22060/2026_koreisai_HW/circuit/output/別紙.pdf

## 1 フットプリント指定について

## 1.1 Mounting Hole

表 1, 画像 1 に示す．

表 1: Mounting Hole のフットプリント指定
項目 | 値 | 単位 | 備考
Pad Diameter | – | –
Hole Diameter | 3.2 | mm
Keepout Diameter | 6.4 | mm

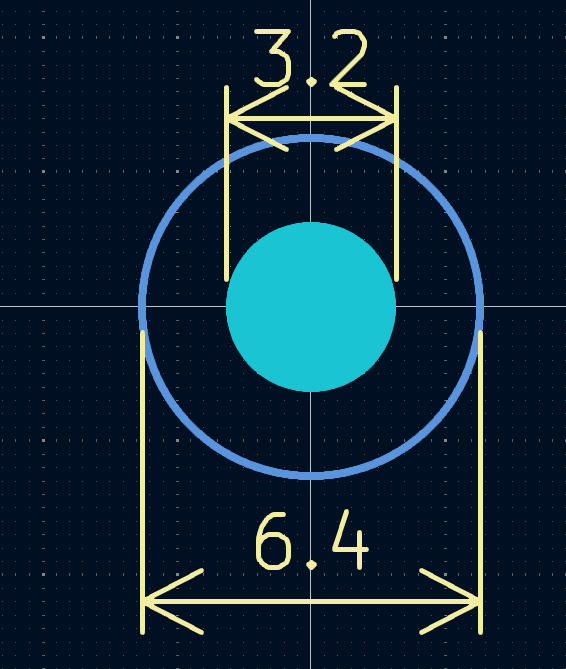
[picture p1: figure]

図 1: Mounting Hole のフットプリント

1.1.1 J2 のフットプリント指定
表 2, 画像 2 に示す．このフットプリントは USB コネクタの配置をせずとも，USB 機能を使用 できるようにするためのものであり，プローブ基板を用いてプログラムの書き込みをできるように するためのものである．

表 2: J2 のフットプリント指定
項目 | 値 | 単位 | 備考
Pad Diameter | 1.7 | mm
Hole Diameter | 1.0 | mm
Keepout Diameter | 0 | mm
pad to pad | 2.54 | mm
amount of pad | 4 | –

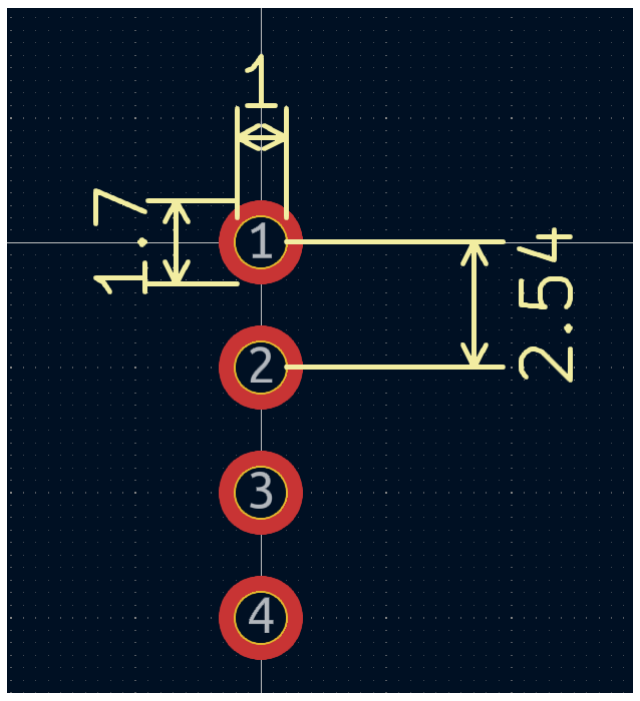
[picture p2: figure]

図 2: J2 のフットプリント

1.1.2 J3 のフットプリント指定
表 3, 画像 3 に示す．このフットプリントはモジュール型の IMU を搭載するときに使用するもの である．ピンヘッダを用いて，基板外に配置するモジュールとの配線を行う方式にする．

表 3: J3 のフットプリント指定
項目 | 値 | 単位 | 備考
Pad Diameter | 1.7 | mm
Hole Diameter | 1.0 | mm
Keepout Diameter | 1.77 | mm
pad to pad | 2.54 | mm
amount of pad | 10 | –

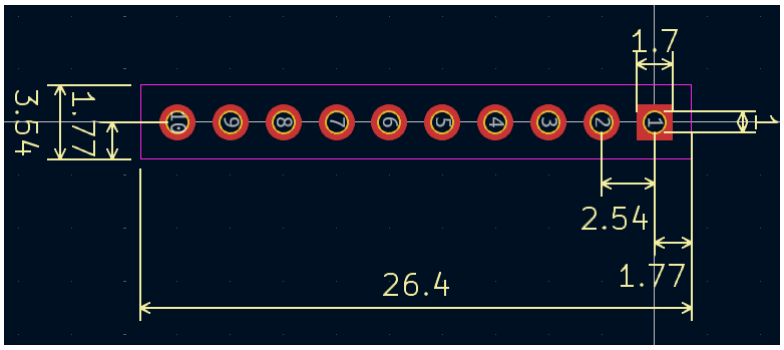
[picture p3: figure]

図 3: J3 のフットプリント

### 1.2 JP1 のフットプリント指定

表 4, 画像 4 に示す．このフットプリントにより，SMD タイプの IMU の I2C アドレスの指定を 行う．

表 4: JP1 のフットプリント指定
項目 | 値 | 単位 | 備考
Pad width | 1.0 | mm
Pad length | 1.5 | mm
Pad to pad | 1.3 | mm

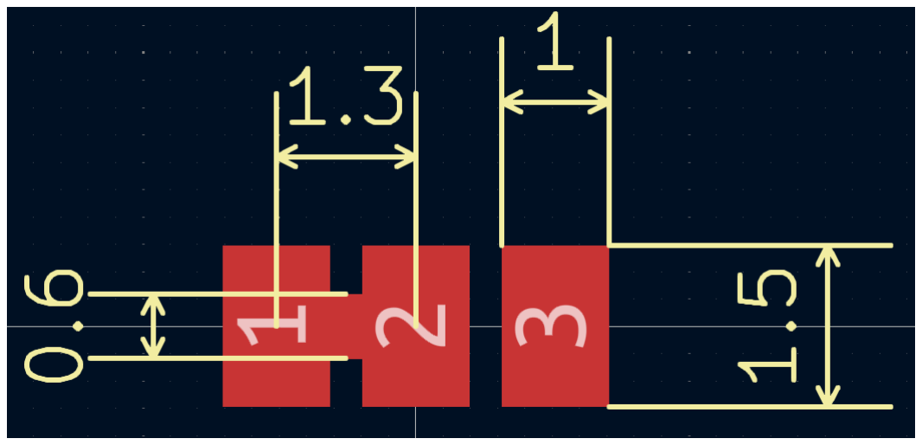
[picture p4: figure]

図 4: JP1 のフットプリント

## 1.3 ESP32-C3-WROOM-02 のフットプリント指定

ESP32-C3-WROOM-02(MCU) のフットプリントについては，データシートが二種類あるた め，こちらに記載を行う．フットプリント等本体仕様については， https://documentation.espressif.com/esp32-c3_datasheet_en.pdf#cd-func-descr に記載されている．ハードウェア設計においては，
https://docs.espressif.com/projects/esp-hardware-design-guidelines/en/latest/esp32c3/pcb-layout-design.html (https://docs.espressif.com/projects/esp-hardware-design-guidelines/en/latest/esp32c3/pcb-layout-design.html)
に記載されている．アンテナ周りのキープアウト等の事項は，ハードウェア設計のほうに記載され ているため，そちらを参照してほしいです．

## 2 シルクスクリーンの表記について

シルクスクリーンの表記については，抵抗/キャパシタ/ダイオードについては RXX/CXX/DXX （XX は部品番号）のように表記する．
また，コネクタである JXX についても同様に JXX（XX は部品番号）のように表記する．（J2 に ついては後述）
IC1,Q1,UX についても同様に IC1/Q1/UX（X は部品番号）のように表記する．
buttonX については button1 のみ RST，その他は buttonX（X は部品番号）のように表記する． JP1 においては，回路図に書かれてる値をシルクスクリーンの表記にする．
J2 においては信号線名を各ピンのそばに表記する．

## 3 大電流箇所について

回路図の MORTOR における箇所においては，ピーク電流が 3.0 A，定常値で 1.0 A 流れること が想定される．そのほかの回路においては最大で 0.3 A 程度の電流（3.3V のレギュレータの出力 直後）が流れることが想定される．

## 4 サーマルパッドについて

5V から 3.3V への降圧に使用する IC まわりにおいては，0.6W 程度の発熱が想定されるため， 放熱用のサーマルパッド/ビアの設置をお願いしたいです．

## 5 外形について

基板の外径については，幅を 30 mm，高さを 150 mm までとし，小さい事には問題がないです． また，Mounting Hole については，基板の四隅に配置をお願いしたいですが，最低でも対角の 2 か 所についていれば問題ないです．コンポーネントの配置や，Mounting Hole の細かな配置において は指定をしないですが，ESP32-C3-WROOM-02 のアンテナについてもこの外形内の収まるよう にしてもらいたいです．
以上について，よろしくお願いします．
設計担当者：古城 隆人
