22060/2026_koreisai_HW/circuit/image/J2.png

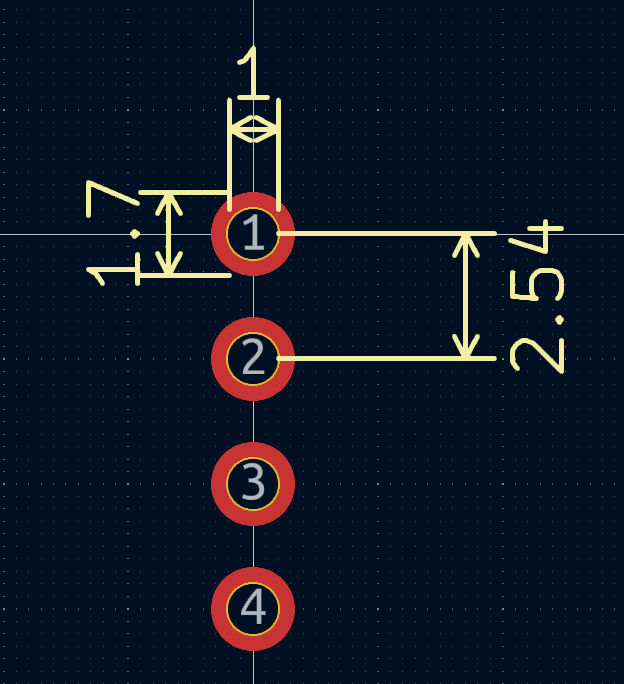
circuit/image/J2.png
