22060/2026_koreisai_HW/circuit/image/J3.png

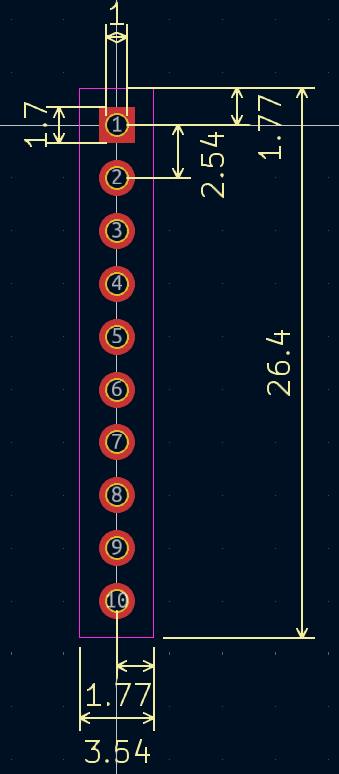
circuit/image/J3.png
