22060/2026_koreisai_HW/circuit/image/JP1.png

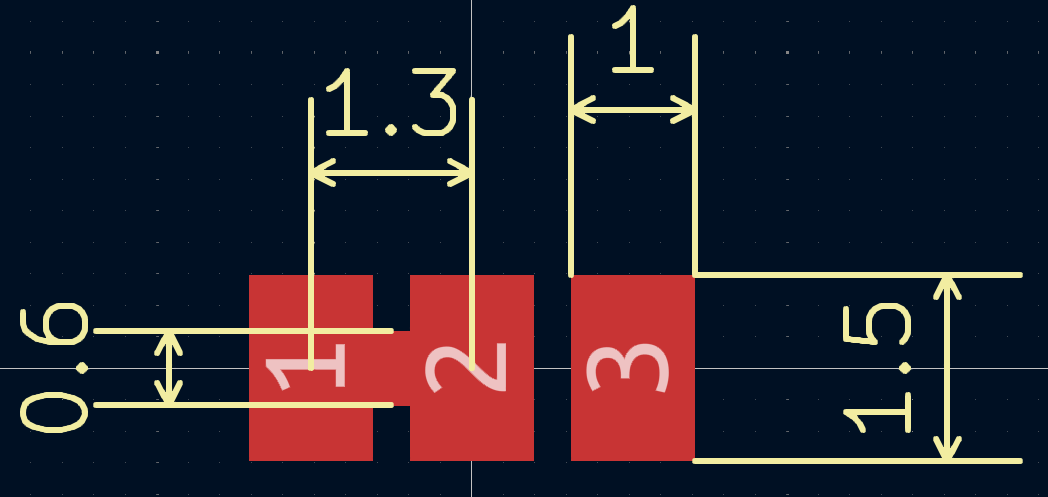
circuit/image/JP1.png
