22060/2026_koreisai_HW/circuit/jlcpcb/production_files/BOM-circuit.csv

Comment | Designator | Footprint | LCSC | Quantity
0.1u | C23 | C_0603_1608Metric | C52923 | 1
10k | R6 | R_0603_1608Metric_Pad0.98x0.95mm_HandSolder | C25744 | 1
5.1k | R23,R24 | R_0603_1608Metric | C23186 | 2
10k | R1 | R_0603_1608Metric_Pad0.98x0.95mm_HandSolder |  | 1
1u | C1 | C_0603_1608Metric |  | 1
1u | C8 | C_0603_1608Metric |  | 1
0.1u | C7 | C_0603_1608Metric |  | 1
0.1u | C6 | C_0603_1608Metric |  | 1
10k | R2 | R_0603_1608Metric_Pad0.98x0.95mm_HandSolder |  | 1
BNO085 | IC1 | BNO085 |  | 1
0.1u | C9 | C_0603_1608Metric |  | 1
TestPoint | TP2 | TestPoint_Pad_D1.5mm |  | 1
10u | C4 | C_0603_1608Metric |  | 1
10u | C5 | C_0603_1608Metric |  | 1
TestPoint | TP4 | TestPoint_Pad_D1.5mm |  | 1
TestPoint | TP3 | TestPoint_Pad_D1.5mm |  | 1
BD33FC0FP | U2 | TO-252-2 |  | 1
USB_C_Receptacle_USB2.0 | J3 | USB_C_Receptacle_GCT_USB4105-xx-A_16P_TopMnt_Horizontal |  | 1
TestPoint | TP1 | TestPoint_Pad_D1.5mm |  | 1
ESP32-C3-WROOM-02 | U1 | ESP32-C3-WROOM-02 |  | 1
Conn_01x10_Pin | J4 | PinHeader_1x10_P2.54mm_Vertical |  | 1
10u | C2 | C_0603_1608Metric |  | 1
4.7k | R3 | R_0603_1608Metric_Pad0.98x0.95mm_HandSolder |  | 1
4.7k | R4 | R_0603_1608Metric_Pad0.98x0.95mm_HandSolder |  | 1
0.1u | C3 | C_0603_1608Metric |  | 1
SW_Push | RST | SW_SPST_PTS810 |  | 1
SW_Push | boot | SW_SPST_PTS810 |  | 1
