22060/2026_koreisai_HW/circuit/circuit.kicad_pcb

## KiCad design circuit/circuit.kicad_pcb (2026-08-03)

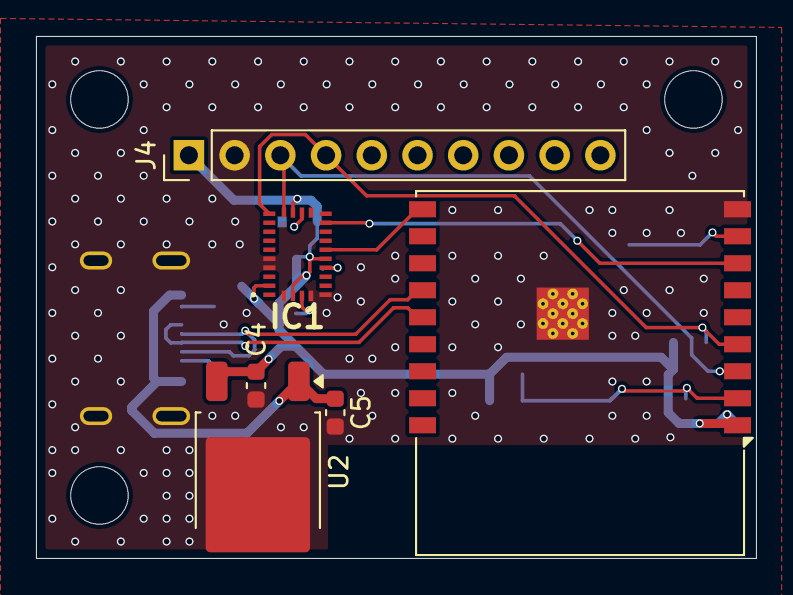
[picture p8: board circuit.kicad_pcb from above]

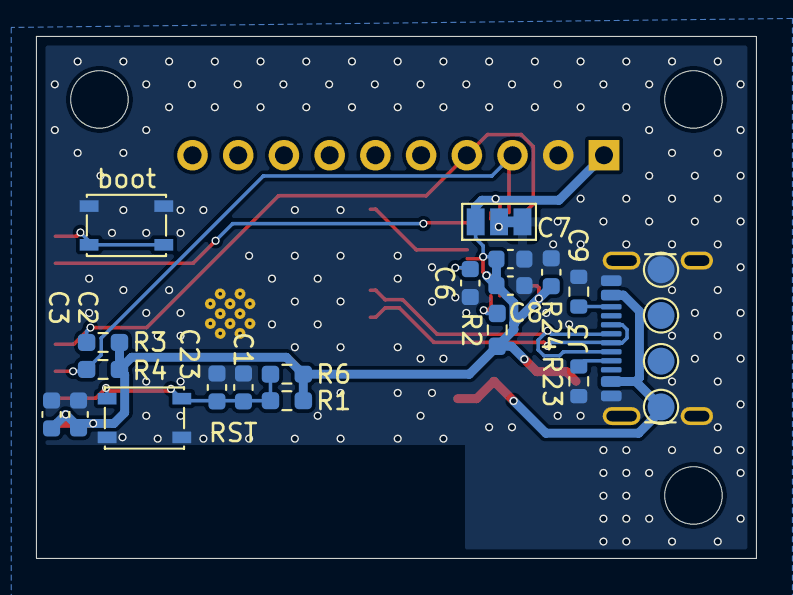
[picture p9: board circuit.kicad_pcb from below]

Board: 2 copper layers, 40.0 x 29.0 mm, 32 parts (23 on the bottom side), 16 nets.

Parts:
C1, C8: 1u; C_0603_1608Metric
C2, C4, C5: 10u; C_0603_1608Metric
C3, C6, C7, C9, C23: 0.1u; C_0603_1608Metric
H1, H2, H3: MountingHole; MountingHole_3.2mm_M3
IC1: BNO085
J3: USB_C_Receptacle_USB2.0; USB_C_Receptacle_GCT_USB4105-xx-A_16P_TopMnt_Horizontal
J4: Conn_01x10_Pin; PinHeader_1x10_P2.54mm_Vertical
JP1: Jumper_3_Bridged12; SolderJumper-3_P1.3mm_Bridged12_Pad1.0x1.5mm_NumberLabels
R1, R2, R6: 10k; R_0603_1608Metric_Pad0.98x0.95mm_HandSolder
R3, R4: 4.7k; R_0603_1608Metric_Pad0.98x0.95mm_HandSolder
R23, R24: 5.1k; R_0603_1608Metric
RST: SW_Push; SW_SPST_PTS810
TP1, TP2, TP3, TP4: TestPoint; TestPoint_Pad_D1.5mm
U1: ESP32-C3-WROOM-02
U2: BD33FC0FP; TO-252-2
boot: SW_Push; SW_SPST_PTS810

Connections:
+3.3V: C2.2, C3.2, C4.1, C7.1, C8.1, C9.1, IC1.3 (VDD), IC1.10 (CLKSEL0), IC1.18 (H_CSN), IC1.28 (VDDIO), J4.1, JP1.3 (B), R1.2, R2.1, R3.1, R4.1, R6.2, U1.1 (3V3), U2.3 (VO)
+5V: C5.1, J3.A4 (VBUS), J3.A9 (VBUS), J3.B4 (VBUS), J3.B9 (VBUS), TP1.1, U2.1 (VCC)
BOOT: U1.8 (IO9), boot.2
D+: J3.A6 (D+), J3.B6 (D+), U1.14 (IO19)
D-: J3.A7 (D-), J3.B7 (D-), U1.13 (IO18)
GND: C1.2, C2.1, C3.1, C4.2, C5.2, C6.1, C7.2, C8.2, C9.2, C23.2, IC1.2 (GND_1), IC1.5 (PS1), IC1.6 (PS0/WAKE), IC1.25 (GND_2), IC1.26 (XOUT32/CLKSEL1), J3.A1 (GND), J3.A12 (GND), J3.B1 (GND), J3.B12 (GND), J3.S1 (SHIELD), J4.2, JP1.1 (A), R23.2, R24.2, RST.1, TP4.1, U1.9 (GND), U1.19 (GND), U2.2 (GND), boot.1
NRST: C1.1, C23.1, R1.1, R6.1, RST.2, U1.2 (EN)
unnamed: IC1.4 (BOOTN), R2.2
unnamed: C6.2, IC1.9 (CAP)
unnamed: IC1.17 (SA0/H_MOSI_), JP1.2 (C)
unnamed: J3.A5 (CC1), R23.1
unnamed: J3.B5 (CC2), R24.1
RST_IMU: IC1.11 (NRST), U1.10 (IO10)
SCL: IC1.19 (H_SCL/SCK/RX), J4.3, R4.2, U1.3 (IO4)
SDA: IC1.20 (H_SDA/H_MISO/TX_), J4.4, R3.2, U1.4 (IO5)
interupt_imu: IC1.14 (H_INTN), U1.7 (IO8)
