22060/2026_koreisai_HW/circuit/devices/led_red_led_smd_led_0603_1608metric_pad1_05x0_95mm_handsolder.txt

PACKAGE 'led_0603_1608metric_pad1_05x0_95mm_handsolder'
CLASS IC
PINCOUNT 2
PINORDER MAIN ,
	K__1,
	A__2
FUNCTION MAIN MAIN ,
	1,
	2
PACKAGEPROP VALUE LED_red
END
