22060/2026_koreisai_HW/circuit/devices/100_resistor_smd_r_0603_1608metric_pad0_98x0_95mm_handsolder.txt

PACKAGE 'r_0603_1608metric_pad0_98x0_95mm_handsolder'
CLASS IC
PINCOUNT 2
PINORDER MAIN ,
	?__1,
	?__2
FUNCTION MAIN MAIN ,
	1,
	2
PACKAGEPROP VALUE 100
END
