22060/2026_koreisai_HW/(commit log)

2026-07-10 add circuit file
2026-10-03 基板動いた．pio最終版
